MatiasV98/gerivoz/(list of files, cad)

Other CAD files:
cad/GERIVOZ_CASE.f3d
