MatiasV98/gerivoz/(commit log)

2026-11-01 README y configuración de PlatformIO
2026-11-01 Firmware: máquina de estados, radio, DSP, ADPCM y audio I2S
2026-11-01 Herramientas de prueba por puerto serie
2026-11-01 Página web de la central (Web Serial)
2026-11-01 Roles base/handy, atención y emergencia, audio de la base hacia la PC
2026-11-01 Config: rol de la placa, ID de la base y doble toque
2026-11-01 Fotos de la placa, el gabinete y la página de la central
2026-11-01 Gabinete del handy (Autodesk Fusion)
    [GERIVOZ_CASE.f3d]
2026-11-01 Página de la central: configuración para 6 residentes
2026-11-07 README: qué versión evaluó la cátedra; sin "bajo costo"; contacto
    - Se separan la versión del congreso (PCM) y la de este repositorio (ADPCM),
    que es la aprobada con enlace de RF a más de 100 m.
    - Se quita "bajo costo", que no tenía respaldo con un costo de materiales.
    - Comentarios de la página: "llamada de voz" en lugar de "emergencia" donde
    corresponde, igual que en el README.
